RickSanchezC5163/xianyu-fpga-synth/assets/README.md

# README 概念封面

`readme-hero.png` 于 2026-09-27 使用 Codex 内置 imagegen 生成，用于展示“键盘输入 → FPGA 实时合成 → 耳机输出”的项目概念。它不是 Tang Mega 60K、NEO Dock 或 SMK-25 的实物照片，也不能作为接线、接口或性能证据。

生成提示词：

```text
Use case: stylized-concept. Asset type: wide GitHub README hero banner for a private FPGA electronic instrument engineering repository. Primary request: a refined, technically credible visual of a compact 25-key MIDI keyboard connected by a single USB cable to a small FPGA development board, with delicate audio waveforms emerging from the board and flowing into a 3.5 mm headphone silhouette. Style: clean premium editorial illustration, subtle isometric perspective, precise circuit traces and understated oscilloscope-wave shapes. Composition: very wide banner, centered core hardware, generous dark negative space along the left and right edges so README title can remain separate above the image. Palette: midnight navy, graphite, restrained cyan and violet accents, small warm gold signal highlights. Mood: thoughtful engineering, musical creativity, real-time digital signal processing. No text, no letters, no logos, no labels, no pseudo-code, no fake measurements, no product-brand marks, no watermark. Concept artwork only, not a claim of an actual product photograph. Suitable for a professional technical repository README.
```
