RickSanchezC5163/xianyu-fpga-synth/docs/LICENSING.md

# 许可说明

自本次许可变更提交起，项目自有内容采用 CC BY-NC-ND 4.0（署名—非商业性使用—禁止演绎），完整条款见根目录 LICENSE。

分享原始内容须保留作者署名、版权和许可信息；不允许商业使用，未经另行授权不得分享改编版本。禁止演绎约束改编版的分享，不等于禁止私人修改。本仓库属于受限公开源码，不属于 OSI 定义的开源软件。

USB Host 上游 Apache-2.0 代码及前端依赖等第三方内容保留原许可，本次变更不重新许可这些内容。参见 THIRD_PARTY_NOTICES.md。

先前发布的 fac8a6e 快照采用 PolyForm Noncommercial 1.0.0。本次变更不撤回此前已经授予的有效许可，也不追溯覆盖历史版本。

共同作者：RickSanchezC5163、CAOH1024。商业使用或改编版分发需另行获得权利人授权。

官方条款：https://creativecommons.org/licenses/by-nc-nd/4.0/
