RickSanchezC5163/xianyu-fpga-synth/docs/VERIFICATION.md

# 公开快照验证记录

2026-11-03，在脱敏导出目录运行，Python 3.12、Icarus Verilog、主机 GCC 与 Node.js。

| 检查 | 结果 |
|---|---|
| RTL fixed 合约回归 | 4/4 通过：起音、重触发松键、STOP 淡出、USB MIDI 完整性 |
| S3 四槽主机测试 | 通过，覆盖发送、读回、恢复和 HTTP 事务适配 |
| 曲谱协议、存储记录、元数据及 HTTP 查询 | 对应 Python/C 主机测试通过 |
| 公开原创曲谱 | 1 首、1 片段，通过实际 C 解析器 |
| 当前四槽网页 | TypeScript 检查与 Vite 生产构建通过，重新生成嵌入资源 |
| 集成 RTL 构建准备 | serial-wifi --prepare-only 通过 |

本次没有重新执行 Gowin 完整布局布线、ESP-IDF 目标编译或设备烧录。历史八槽网页测试依赖未发布的第三方曲库，不纳入此快照；当前四槽网页的目标板交互仍需部署后复核。

## 历史完整工程记录

完整实板构建记录：Logic 35,607/59,904；CLS 27,369/29,952；寄存器 27,299/60,780；DSP 40/118；BSRAM 29/118。最差 Setup +0.015 ns，Hold +0.180 ns。该记录不是本公开快照的新综合结果，不能据此保证后续改动时序收敛。

数字仿真和示波器测量的端点不同。约 380 μs 为特定配置和端点下的实板观察，不表示全输入扫描、USB、包络与模拟输出在所有条件下的最坏延迟。外置标准 I²S DAC 的完整实物验收未纳入本公开记录。
