RickSanchezC5163/xianyu-fpga-synth/(commit log)

2026-11-03 Publish sanitized Xianyu FPGA synthesizer source snapshot
    [partitions.csv]
2026-11-03 Change current public license to CC BY-NC-ND 4.0
