RickSanchezC5163/xianyu-fpga-synth/(notices)

Notices in the files:
README.md:
License: CC BY-NC-ND 4.0
